Eissa-Elbashir/Control-Robotic-Arm-using-EMG/PosterPDF.pdf

# ROBOTIC ARM USING ELECTROMYOGORAGHY

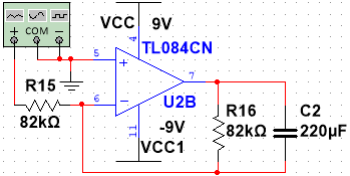
[picture p1: figure]

- Every year in the UK, accidents and injuries gradually increase, and some are suffering from amputation due to fatal injuries, diseases, or infections. According to Diabetes UK data showed 27465 amputations from 2015 to 2018¹ .
- Getting a prosthetic arm usually costs around 5500£ to 60000£ which is not affordable for everyone, especially for children who are growing up²
. They
would need to replace the prosthetic arm every few years.
- The project aims to create a prosthetic arm using low-budget components like a 3D printer, servos and microcontroller that is affordable for everyone, easy to use for children and has a large range of freedom of movement.
- Research into arm muscle anatomy and existing robotic arms.
- Simulating the circuit and calculating the value of the components.
- Building a prototype of the circuit and testing it.
- Translating the collected data into useful data using Arduino.
- Building and assembling all the parts.
- Resistors
- Capacitors
- TL084 chip
- LM386 chip
- 1N4148 diode

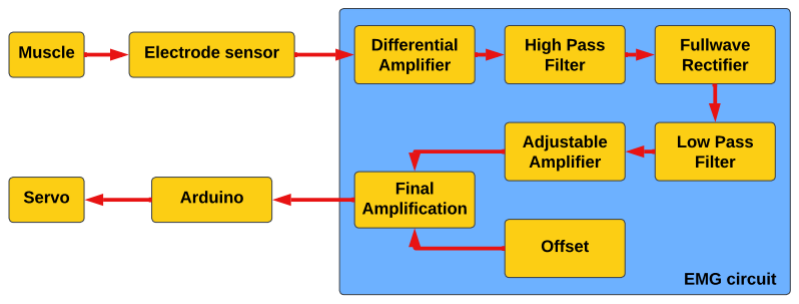
[picture p2: figure]
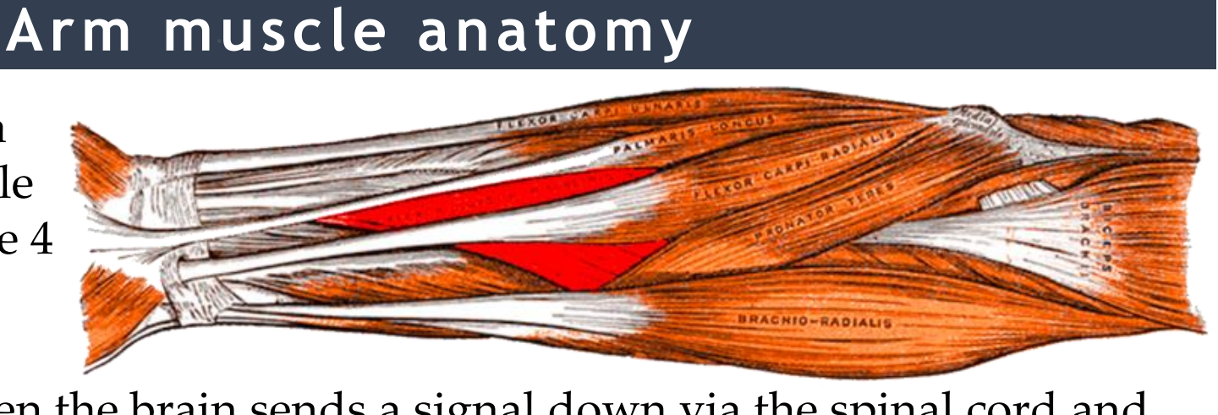
[picture p3: figure]
Arm muscle anatomy

The muscle contract when the brain sends a signal down via the spinal cord and then via motor neurons to the muscle this produces an action potential which is

In the forearm, there is a muscle group responsible
for the movements of the 4
fingers called flexor
digitorum superficial.

Problem statement

Aim

Objective

Project diagram

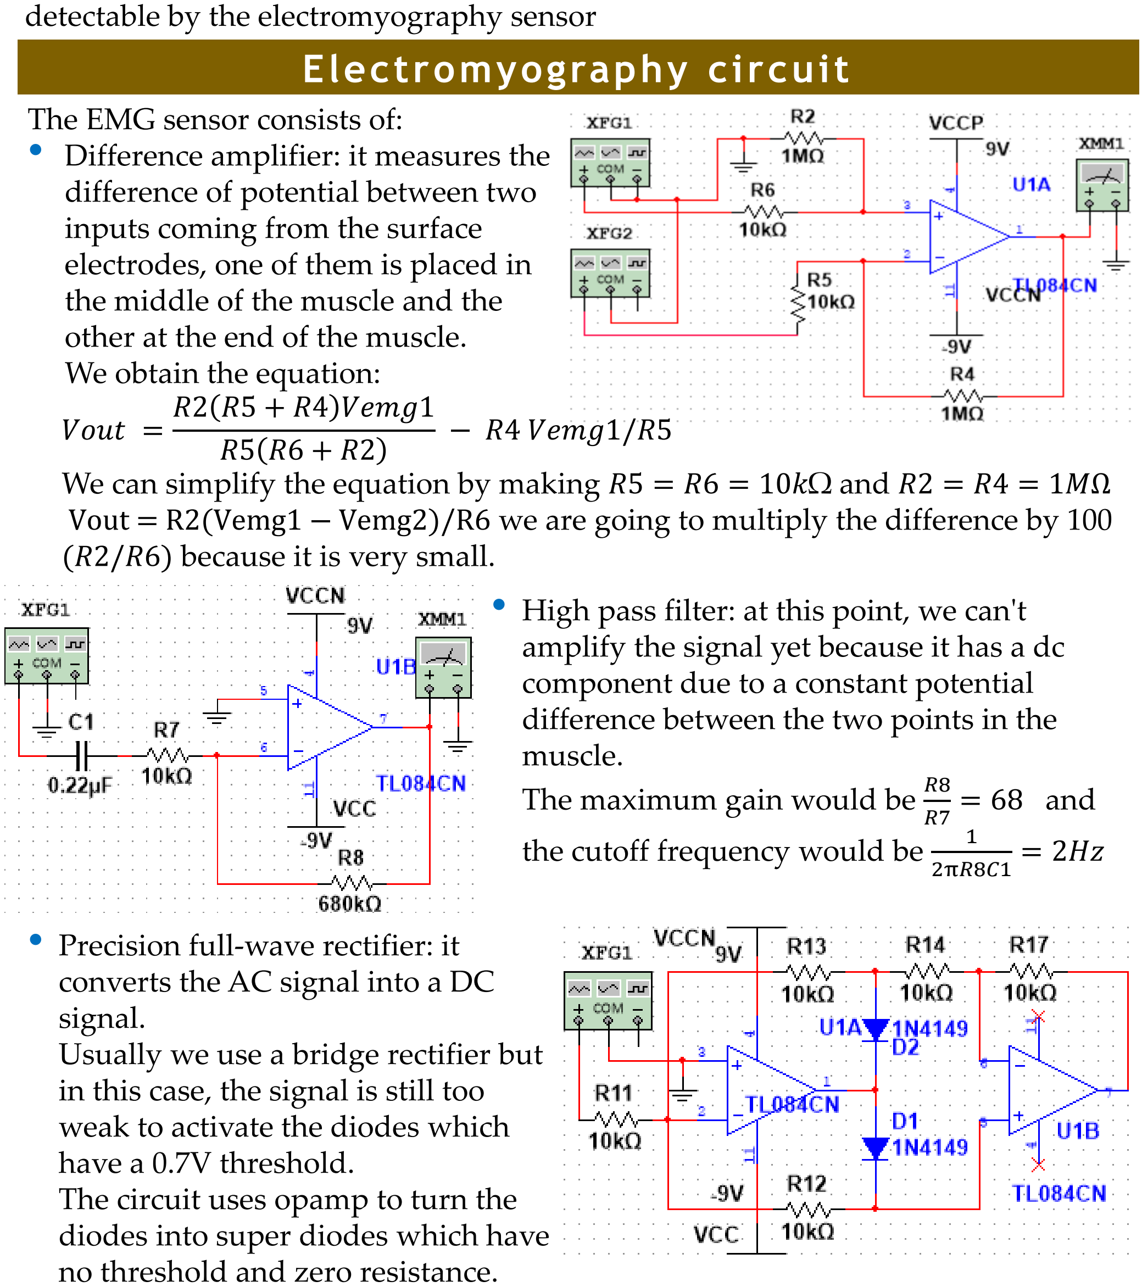
[picture p4: figure]
detectable by the electromyography sensor Electromyography circuit; The EMG sensor consists of: • Difference amplifier: it measures the; difference of potential between two inputs coming from the surface electrodes, one of them is placed in the middle of the muscle and the other at the end of the muscle. • We obtain the equation:; Vout =; R2 R5 + R4 Vemg1; − R4 Vemg1/R5; (R2/R6) because it is very small.; component due to a constant potential; muscle. • The maximum gain would be R8 R7; = 68 and; the cutoff frequency would be; • Precision full-wave rectifier: it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

We can simplify the equation by making R5 = R6 = 10kΩ and R2 = R4 = 1MΩ Vout = R2(Vemg1 − Vemg2)/R6 we are going to multiply the difference by 100

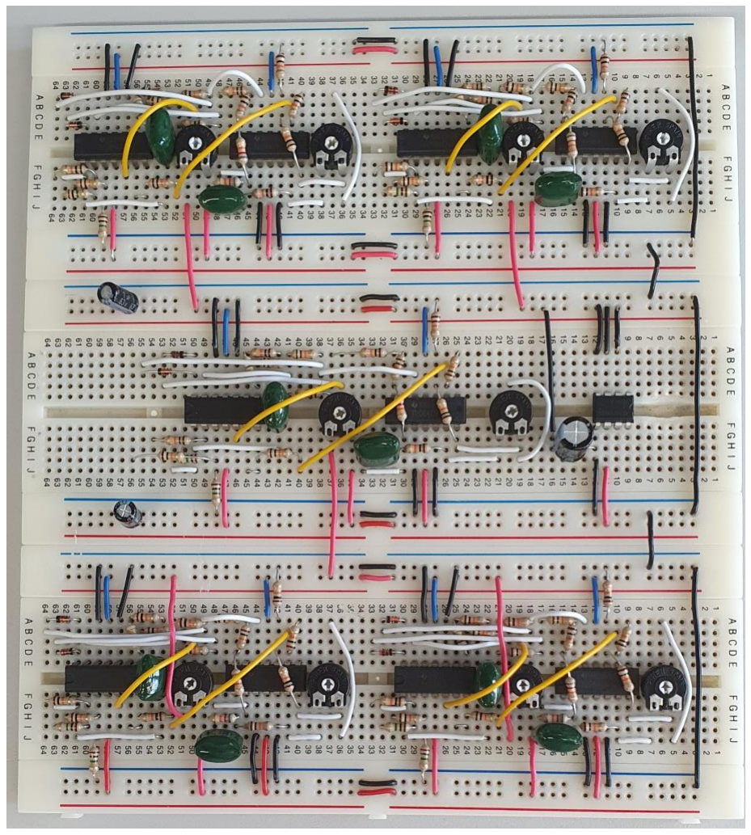
[picture p5: figure]
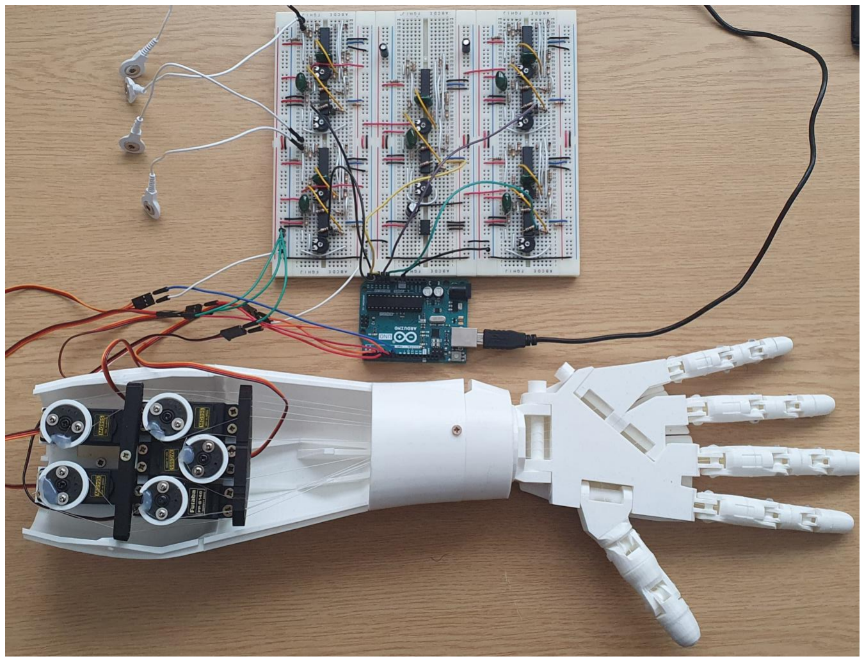
[picture p6: figure]

- High pass filter: at this point, we can't amplify the signal yet because it has a dc

difference between the two points in the

- Low pass Filter: it smooths the output of the rectifier by removing high frequencies and making the signal suitable for Arduino.
- The maximum gain would be
R16
R15

= 1 and the cutoff frequency would be

1
2πR16C2

= 10Hz

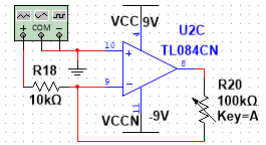
[picture p7: figure]

- Adjustable amplifier:
- Vout = −

R2
R1

Vin it provides an
adjustable gain up to 50.
- Offset selector: output Vout is the voltage selected by the 100 kΩ potentiometer because it is a voltage follower.

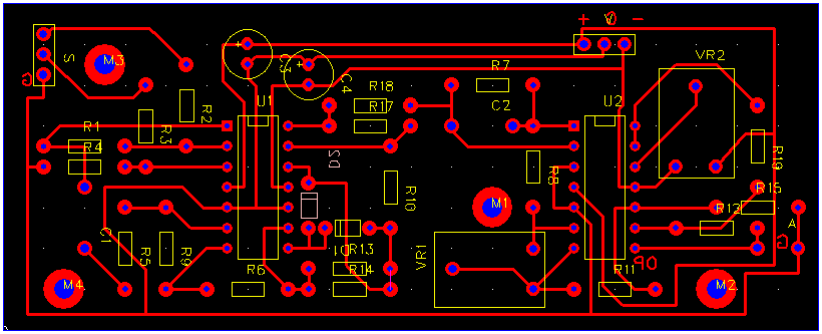
[picture p8: figure]

Code

PCB component:

- Hardware: it consists of an electrode sensor and
EMG circuit to measure
muscle contraction.
- Software: it contains an Arduino to convert the
muscle contraction into
servos movement.

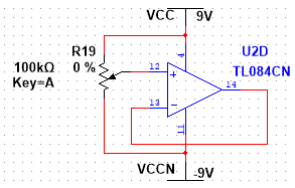
[picture p9: figure]

### Printed circuit board PCB

Arduino code steps:
- Configuring all inputs and outputs for all five fingers using pinMode.
- Reading the voltage from the EMG circuit that measures muscle contraction.
- Convert the to 9v reading using Voltage = (9. / 1023.) * Analogue reading
- Using exponential moving average to smooth out the servo movement depending on the alpha value current avg = voltage ∗ Alpℎa + (last avg ∗ (1 − Alpℎa))
- Determining the servo positions that is equal to the signal using the slope of 2 points formula (Angle1 – Angle2) = m (Voltage1 – Voltage2)
Data

The graph represents real-time data on the muscle contraction of five fingers. Each colour represents a movement of a finger. The horizontal axis is time and the vertical axis measures the contraction power. The peak of each colour increases whenever the EMG circuit detects a movement.

Reference:
[1] the global diabetes community, “Rising number of diabetes-related amputations in England”, February 27 2020.
[2] healthcare service, LUXMED. Available (online) February 9 2023: https://luxmedprotez.com/en/prosthetic-arm-price/

The robotic arm design form https://inmoov.fr/

Final design

Student: Eissa Elbashir

Supervisor: Dr Baha
University of Brighton

Conclusion

The project aimed on the development of a prosthetic arm for amputees. The result has shown that the model was successfully able to detect the movement of each finger and translate it into data that was been processed by a microcontroller. However, there is still room for future improvement and further research, specifically in the accuracy of EMG circuits and signal processing.

Course: Electronics and Computer Engineering

Internal Examiner: Dr Gavin
